kevin-cazal/rfid_door/schematic.png

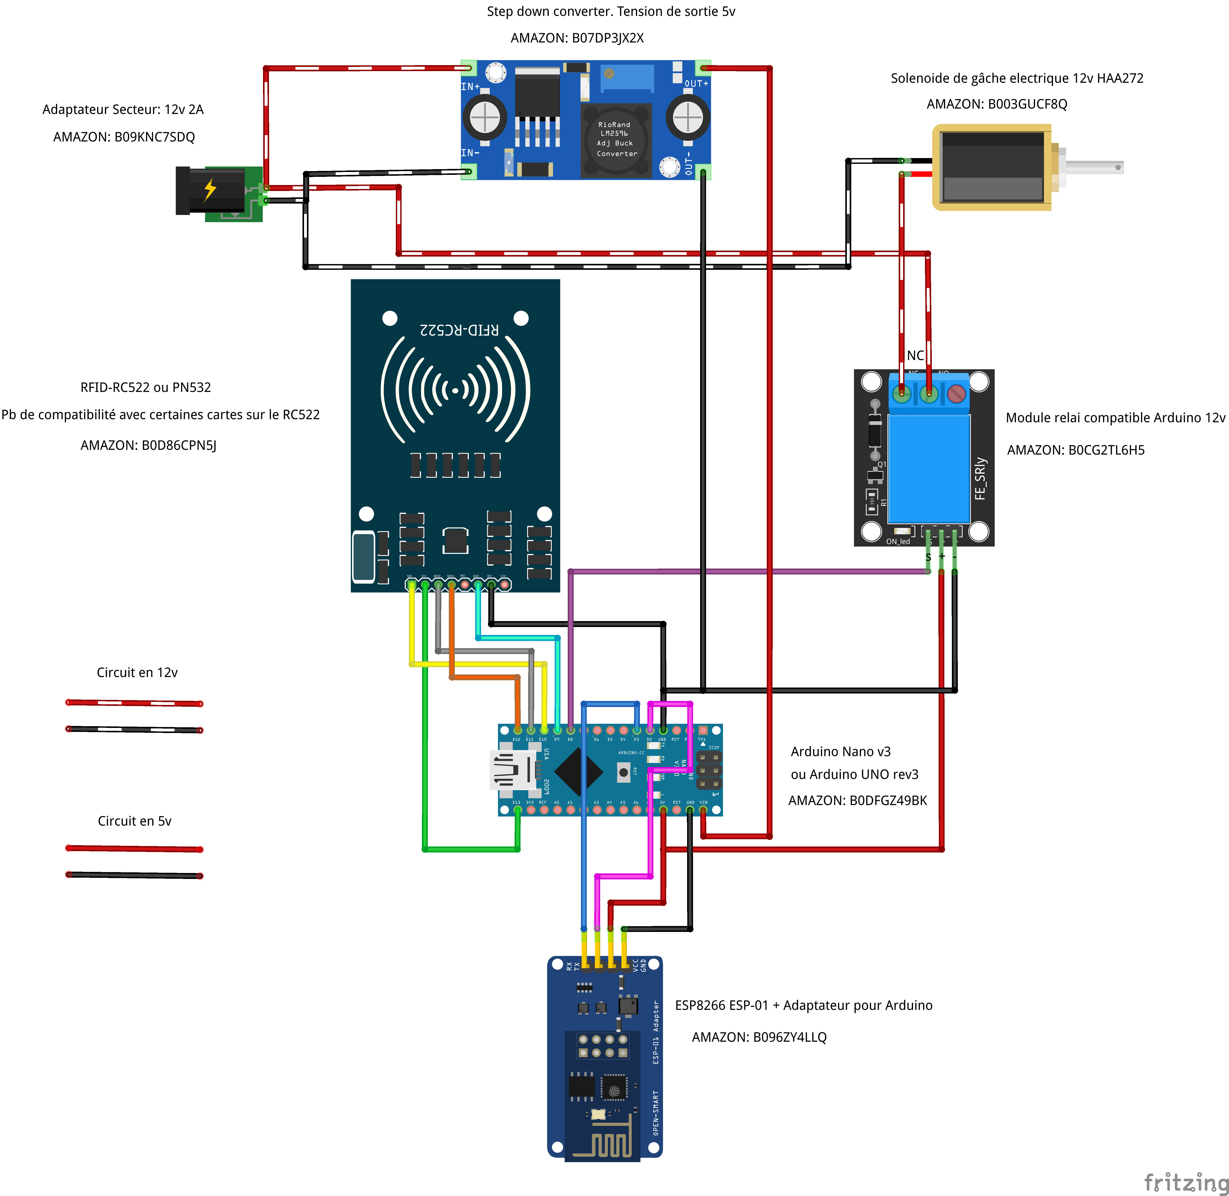
schematic.png
